svofski/satashnik/README.md

# satashnik
Satashnik is a nixie clock based on IN-2 tubes, AVR ATmega8 microcontroller and DS3234 TCXO real-time clock with supercap backup power.

satashnik

Please see full project writeup at http://sensi.org/~svo/satashnik
