svofski/satashnik/eagle/nixie-in2-x3-nixieboard.pdf

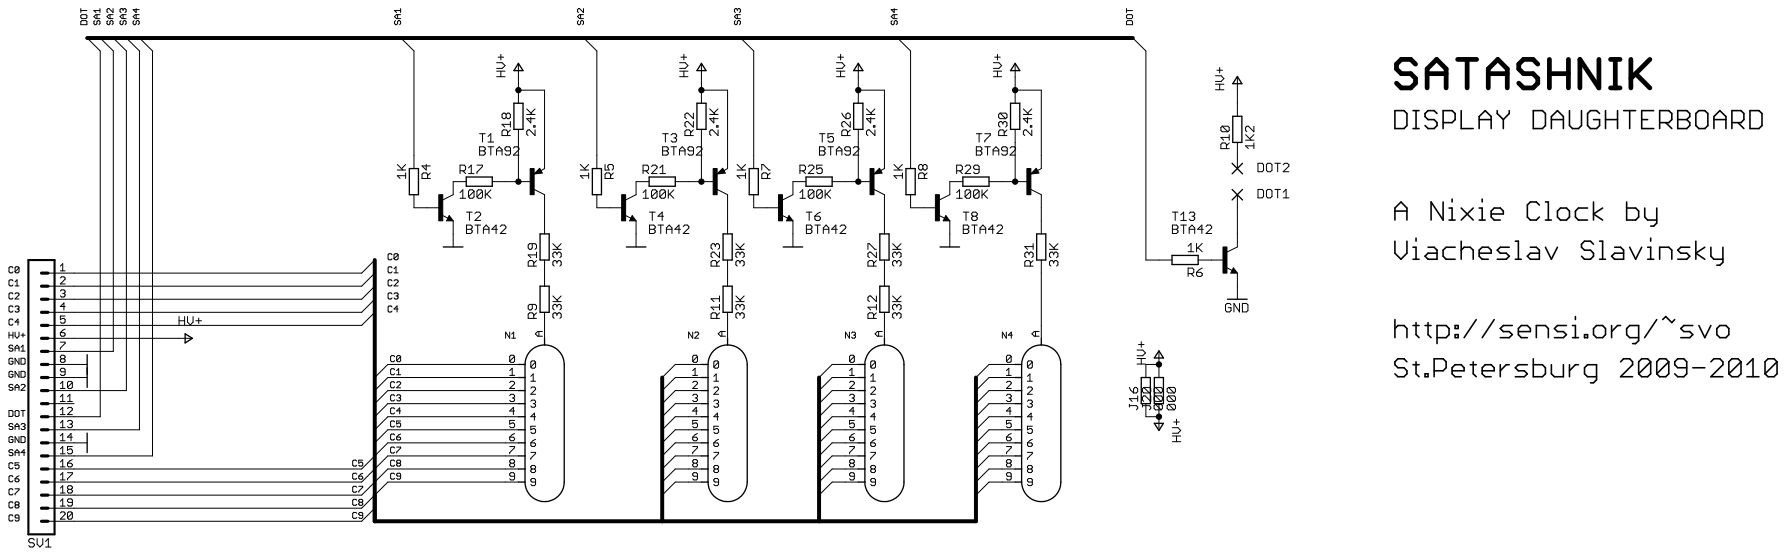
[picture p1: page 1]
