svofski/satashnik/eagle/nixie-in2-x3.1-mainboard.pdf

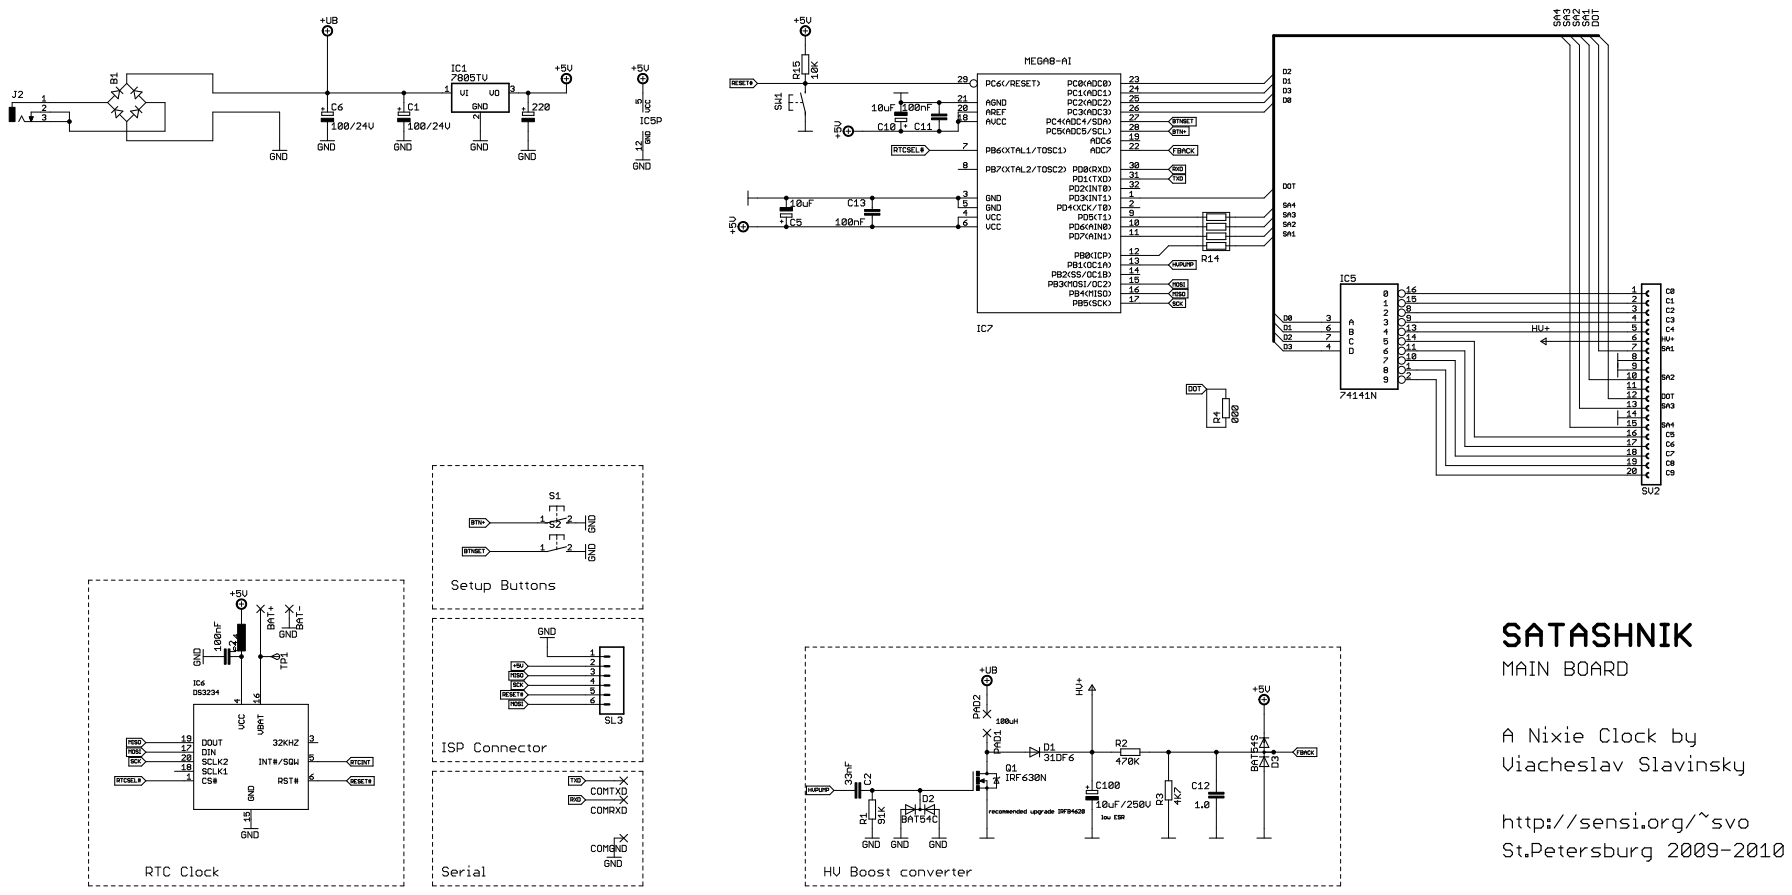
[picture p2: page 1]
