svofski/satashnik/src/voltage.c

#include <inttypes.h>
#include <avr/io.h>
#include <avr/interrupt.h>
#include "voltage.h"
#include "util.h"

#include <stdio.h>

volatile uint16_t voltage;                            //!< voltage (magic units)
static volatile uint16_t voltage_setpoint = VOLTAGE_WASTE;   //!< voltage setpoints (magic units)

static const uint16_t ocr1a_reload = 121;

void pump_init() {
    // set fast pwm mode
    // COM1A1:0 = 10, clear oc1a on compare match, set at top
    // COM1B1:0 = 00, normal port operation
    // no FOC
    // WGM11:10 (WGM = Fast PWM, TOP=ICR1: 1110) = 11
    TCCR1A = BV2(COM1A1, WGM11);
    TCCR1B = BV2(WGM13,WGM12);
    
    OCR1A = ocr1a_reload; 
    ICR1 = 170;
    
    TCCR1B |= _BV(CS10); // clk/1 = 8MHz
    
    DDRHVPUMP |= BV2(1,2);
}

void pump_nomoar() {
    ADCSRA = 0;
    ADCSRA |= _BV(ADIF); 

    ICR1 = 255;
    OCR1A = 0;
    OCR1B = OCR1A;
}

void pump_faster(int8_t dfreq) {
    ICR1 += dfreq;
}

void adc_init() {
    voltage = 0;
    
    // PORTA.7 is the feedback input, AREF = AREF pin
    ADMUX = 7;  
    //DDRA &= ~_BV(7);

    // ADC enable, autotrigger, interrupt enable, prescaler = 111 (divide by 32)
    ADCSRA = BV6(ADEN, ADFR, ADIE, ADPS2, ADPS1, ADPS0); 
    //ADCSRA = BV5(ADEN, ADIE, ADPS2, ADPS1, ADPS0); 

    ADCSRA |= _BV(ADSC); 
}

/// Start voltage booster
void voltage_start() {
    adc_init();
    pump_init();
}

uint16_t voltage_getbcd() {
    // 1024 = 500V
    uint16_t val = (voltage * 32) / 65;
    return tobcd16(val);
}

inline uint16_t voltage_get() {
    return voltage;
}

void voltage_set(uint16_t setpoint) {
    voltage_setpoint = setpoint;
}

inline uint16_t voltage_setpoint_get() { return voltage_setpoint; }

ISR(ADC_vect) {
    voltage = (voltage + ADC) / 2;
    if (voltage < voltage_setpoint) {
        OCR1A = ocr1a_reload;
    } else {
        OCR1A = 0;
    }
}
