svofski/satashnik/(commit log)

2010-01-18 fixed forgotten RTCSEL# in schematic everything works, modes hhmm/mmss, voltmeter no brightness levels though, at 1/4th probably not too bright anyway
    [buttonry.c, buttonry.h, main.c, rtc.c, rtc.h, util.c, util.h, voltage.c]
2010-01-20 fixed fades no blinking while setting button is depressed preservation mode is invoked by set button in voltmeter mode
    [buttonry.c, main.c, util.h, voltage.c, voltage.h]
2010-01-22 many things
    [nixie-in2-x3.1-mainboard.brd, nixie-in2-x3.1-mainboard.sch]
2010-01-22 blinking fixed
    [nixie-in2-x3.1-mainboard.brd, nixie-in2-x3.1-mainboard.sch]
2010-01-23 dot is driven by Timer2 at fast speed, sustains discharge when off
2010-01-23 fixed calendar bug (october 0x10 not 10)
    [main.c]
2010-01-23 powersave mode fixed
2010-01-26 Rev.B of the main board: fixed layout bugs that were found and fixed with wires.
    [nixie-in2-x3-nixieboard.sch, nixie-in2-x3.1-mainboard.brd, nixie-in2-x3.1-mainboard.sch]
2010-02-12 strobeshnik
    added patashnik enclosure template to the repo
2010-02-16 voltages for harmoshnik
2016-02-12 updated uart recv isr syntax
2016-02-12 pulled satashnik-eagle
    [nixie-in2-x1.brd, nixie-in2-x1.sch, nixie-in2-x2.brd, nixie-in2-x2.sch, nixie-in2-x3-mainboard.brd, nixie-in2-x3-mainboard.sch, nixie-in2-x3-nixieboard.brd, nixie-in2-x3-nixieboard.sch]
